TriTacLe/kitticopter-control/report/tex/titlepage.tex

\begin{titlepage}
\begin{center}

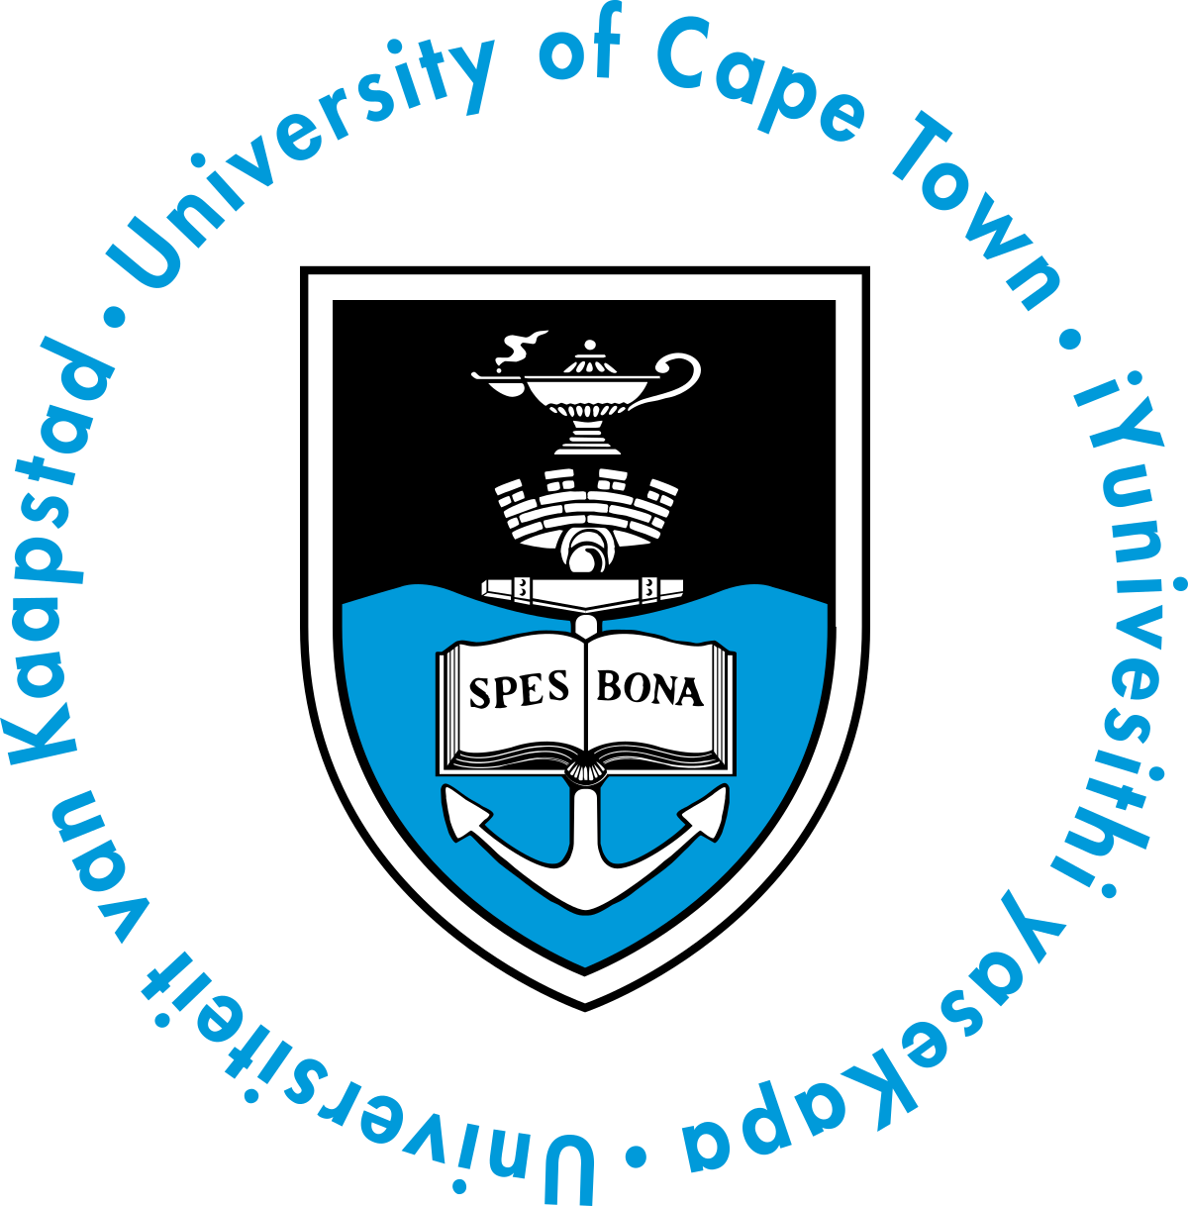
[picture p6: report/UCTLOGO.png]
~\\[2cm]

\HRule \\[0.4cm]
{ \LARGE
  \textbf{Lab 2 Report}\\[0.4cm]
  \emph{Proportional Control}\\[0.4cm]
}
\HRule \\[1.5cm]

{ \large
  Tri Tac Le\\[0.2cm]
  EEE3094S Control Systems Engineering\\[0.2cm]
  LXXTRI004
}

\vfill

\textsc{\large Mechatronics, Department of Electrical Engineering}\\[0.4cm]
{\large \today}

\end{center}
\end{titlepage}

% Sits before the page counter is reset, so it must not print a number of its own.
\thispagestyle{empty}
\section*{Declaration}

\begin{enumerate}
    \item I know that plagiarism is a serious form of academic dishonesty.
    \item I have read the document about avoiding plagiarism, am familiar with its contents
          and have avoided all forms of plagiarism mentioned there.
    \item Where I have used the words of others, I have indicated this by the use of
          quotation marks.
    \item I have referenced all quotations and properly acknowledged other ideas borrowed
          from others.
    \item I have not and shall not allow others to plagiarise my work.
    \item I declare that this is my own work.
\end{enumerate}

\vspace{1.5em}

\noindent Name: Tri Tac Le \hfill Student number: LXXTRI004

\vspace{2.5em}

\noindent Signature: Tri Tac Le \hfill Date: \today

\newpage
