TriTacLe/kitticopter-control/report/figures/fbd.pdf

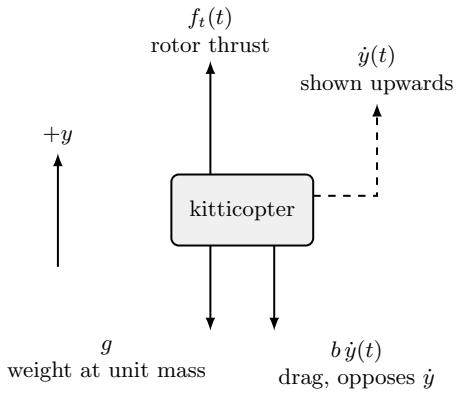
[picture p7: figure]
kitticopter; ft(t) rotor thrust; b y˙(t) drag, opposes ˙y; g weight at unit mass; y˙(t) shown upwards
