TriTacLe/kitticopter-control/report/figures/schematic.pdf

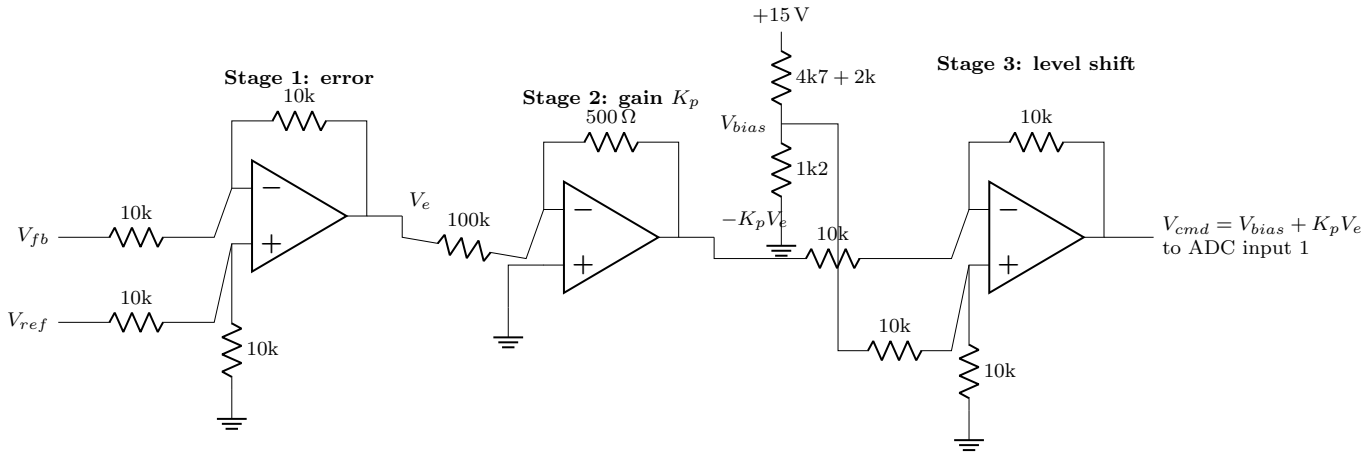
[picture p8: figure]
Stage 1: error; Vref; Stage 2: gain Kp; −KpVe; Vbias; Stage 3: level shift; Vcmd = Vbias + KpVe to ADC input 1
