TriTacLe/kitticopter-control/report/figures/spice_sweep.png

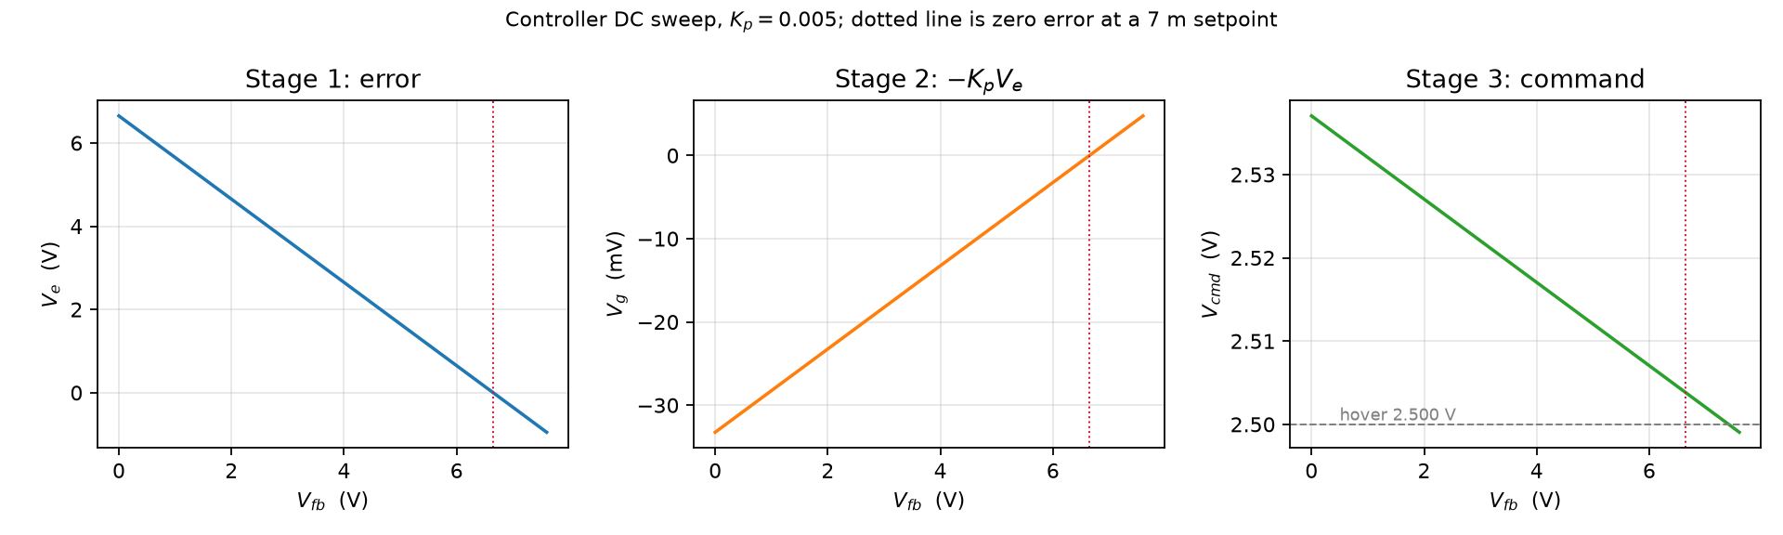
report/figures/spice_sweep.png
