TriTacLe/kitticopter-control/report/figures/blockdiagram.pdf

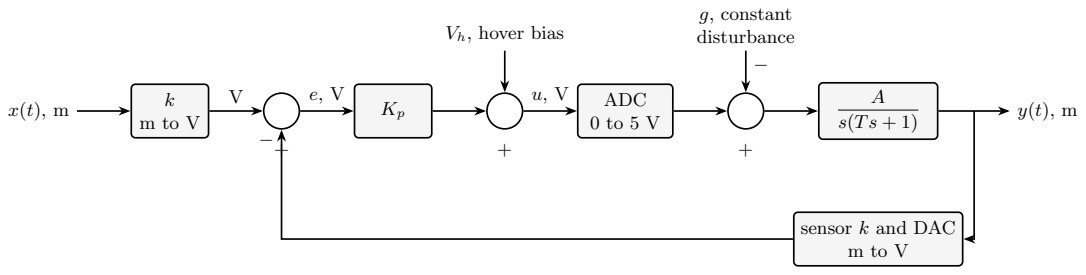
[picture p10: page 1]
ADC 0 to 5 V; g, constant disturbance

Vh, hover bias

sensor k and DAC
