TriTacLe/kitticopter-control/kicad/controller.pdf

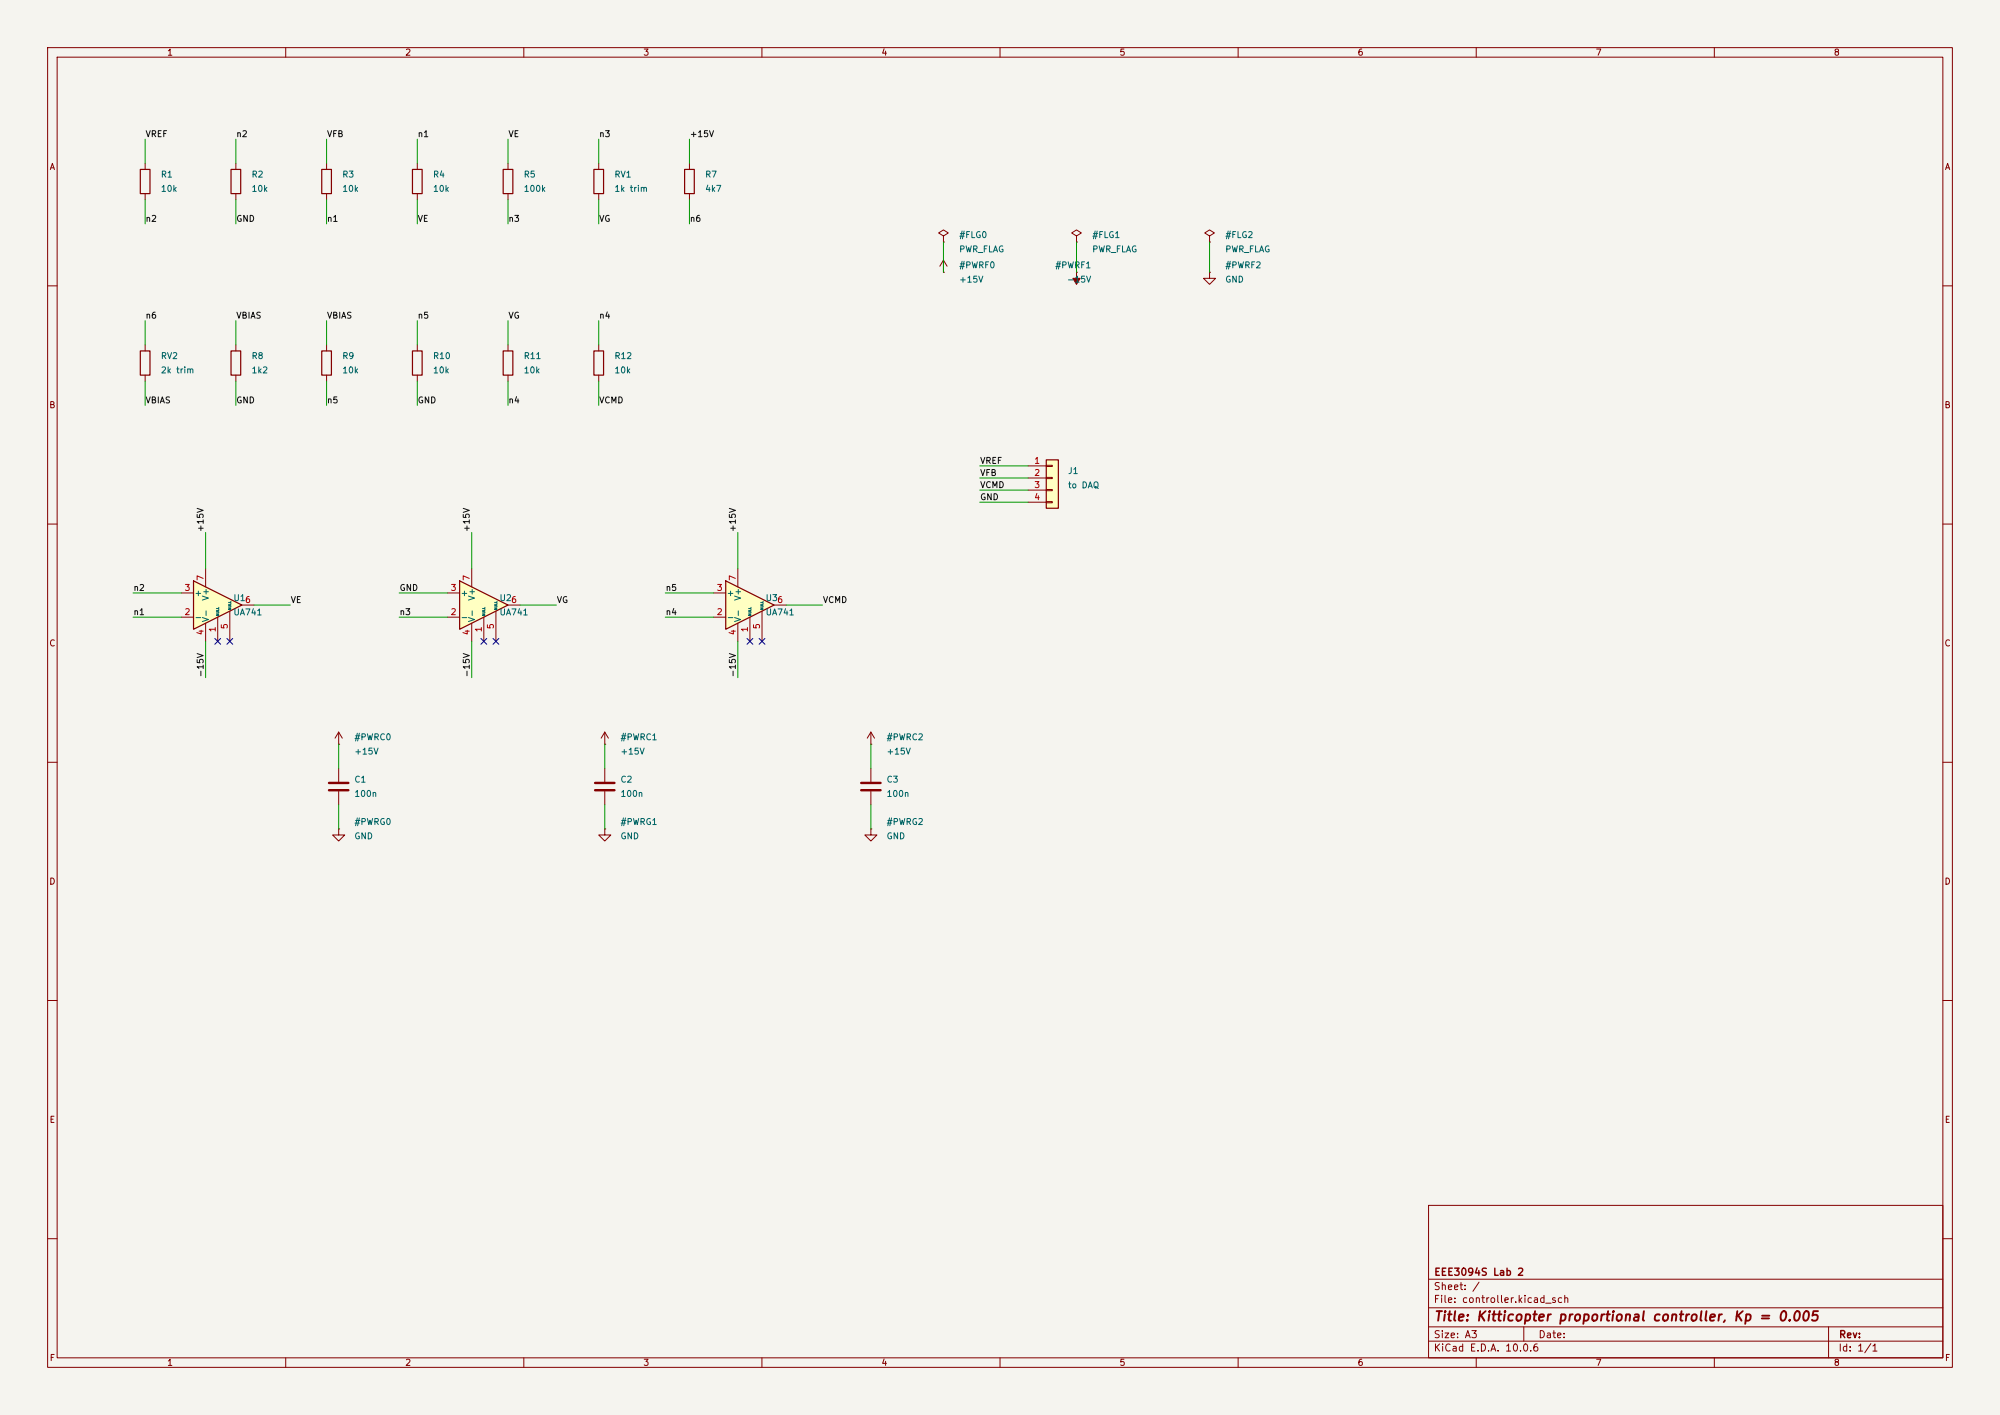
[picture p11: page 1]

Sheet: /
File: controller.kicad_sch
Title: Kitticopter proportional controller, Kp = 0.005

Size: A3 | Rev: | F Date:
KiCad E.D.A. 10.0.6 | Id: 1/1
