TriTacLe/kitticopter-control/kicad/controller.kicad_sch

## KiCad design kicad/controller.kicad_sch (2026-10-09)

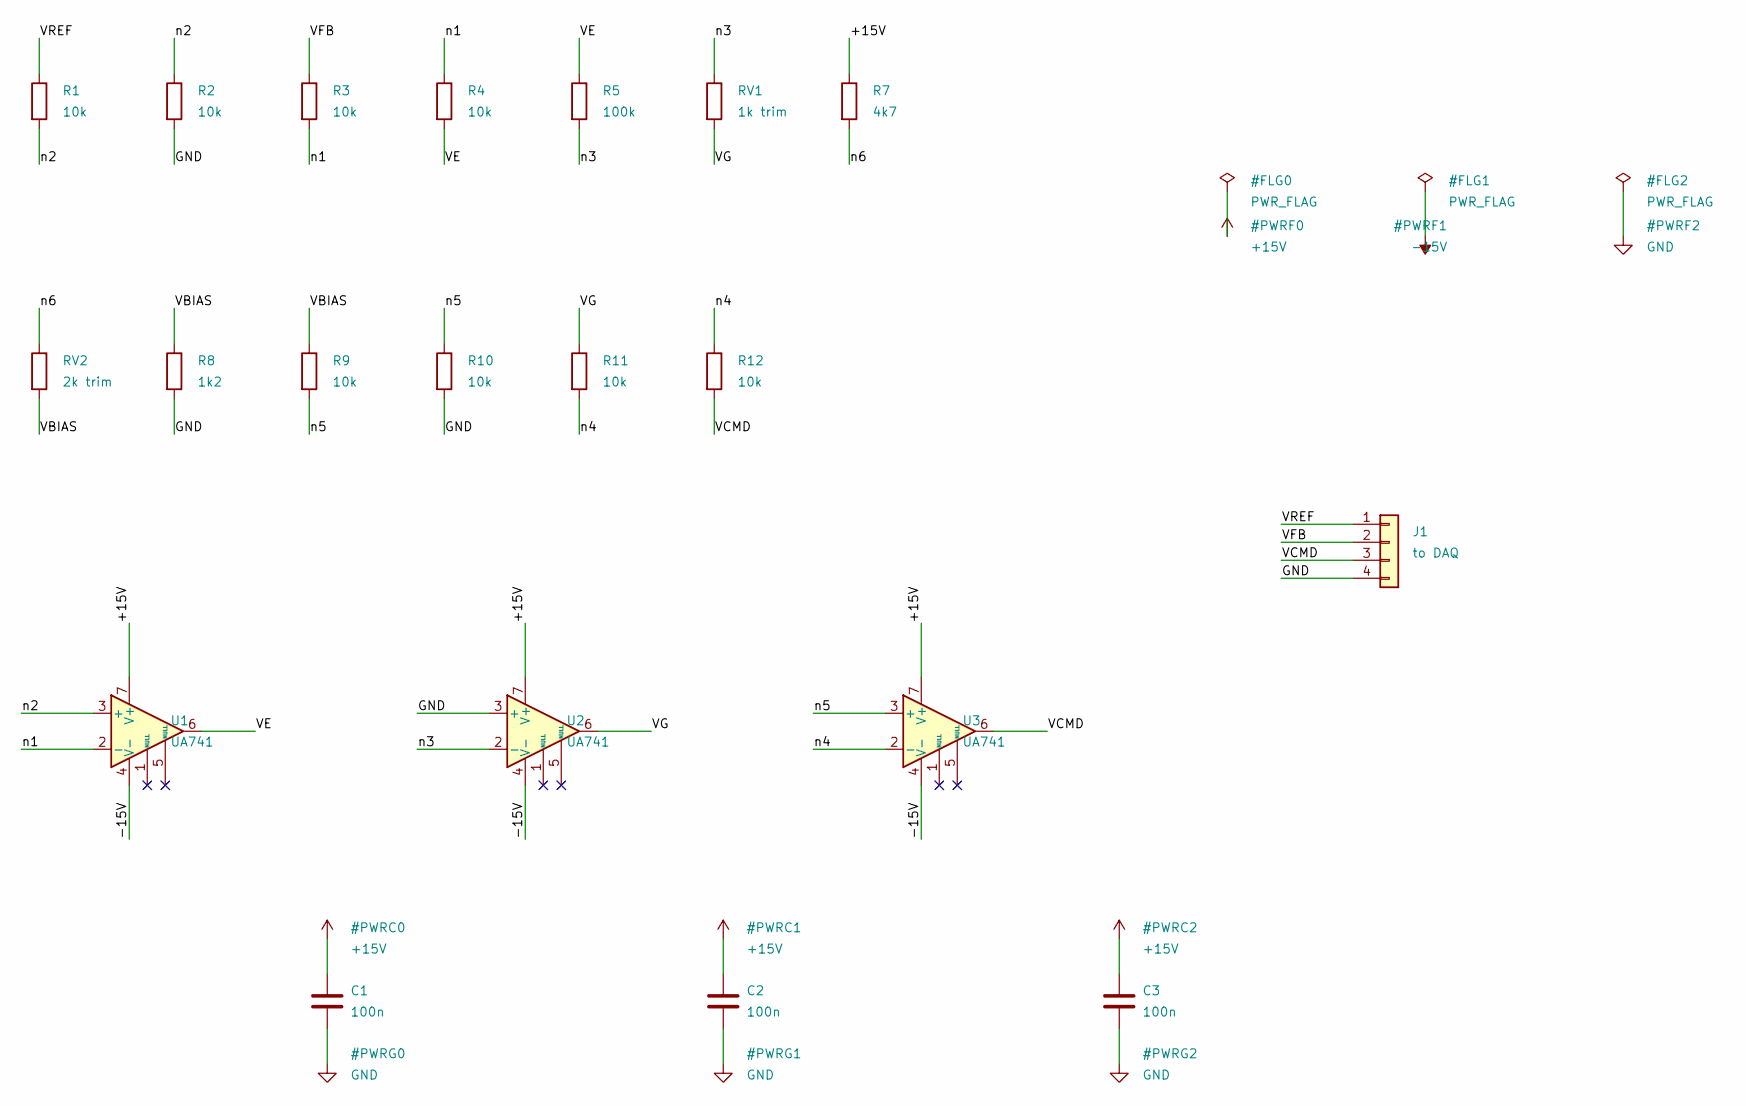
[picture p12: schematic controller.kicad_sch]

Parts:
C1, C2, C3: 100n
J1: to DAQ
R1, R2, R3, R4, R9, R10, R11, R12: 10k
R5: 100k
R7: 4k7
R8: 1k2
RV1: 1k trim
RV2: 2k trim
U1, U2, U3: UA741

Connections:
+15V: C1.1, C2.1, C3.1, R7.1, U1.7 (V+), U2.7 (V+), U3.7 (V+)
-15V: U1.4 (V-), U2.4 (V-), U3.4 (V-)
GND: C1.2, C2.2, C3.2, J1.4, R2.2, R8.2, R10.2, U2.3 (+)
VBIAS: R8.1, R9.1, RV2.2
VCMD: J1.3, R12.2, U3.6
VE: R4.2, R5.1, U1.6
VFB: J1.2, R3.1
VG: R11.1, RV1.2, U2.6
VREF: J1.1, R1.1
n1: R3.2, R4.1, U1.2 (-)
n2: R1.2, R2.1, U1.3 (+)
n3: R5.2, RV1.1, U2.2 (-)
n4: R11.2, R12.1, U3.2 (-)
n5: R9.2, R10.1, U3.3 (+)
n6: R7.2, RV2.1
